chrisvdg/solder_fume_extractor/schema/README.md

# Schematics

In [wiring.dsn](./wirind.dsn) you can find a schematic drawn up with TinyCAD.
