chrisvdg/solder_fume_extractor/(list of files, drawings)

Other design files:
schema/wiring.dsn
