chrisvdg/solder_fume_extractor/(threads)

Thread 1 (2020-05-27):

Adjust PWM frequency

chrisvdg, 2020-05-27:
In the docs I state that I run my ATTINY85 on 1MHz. They eliminates the PWM fan noise but I have noticed flickering on the LEDs when filming them.

I think it would be better to set it up at the default (?)  8 MHz and adjust the PWM frequency in code that does not have the PWM fan noise not the LED flickr.
Maybe the adjust in code allows for separate frequencies on the outputs which could help find a solution for the 2 problems
