chrisvdg/solder_fume_extractor/(commit log)

2020-05-21 Adds basic version arduino code
2020-05-21 Adds hysteresis for led and fan
2020-05-21 Adds floor parameters for led and fan
2020-05-21 Adds hard start fan
2020-06-06 Adds wiring schema (using TinyCad )
    [wiring.dsn]
2020-06-06 Adds wiring schema JPG
2020-06-06 updates readme with schematics
    [wiring.dsn]
2020-06-12 Small tweaks schema
    [wiring.dsn]
2020-06-25 Replaces mosfet flyback diodes with zener diodes
    [wiring.dsn]
